snebragd/stringent/Hardware/plotter3.stl

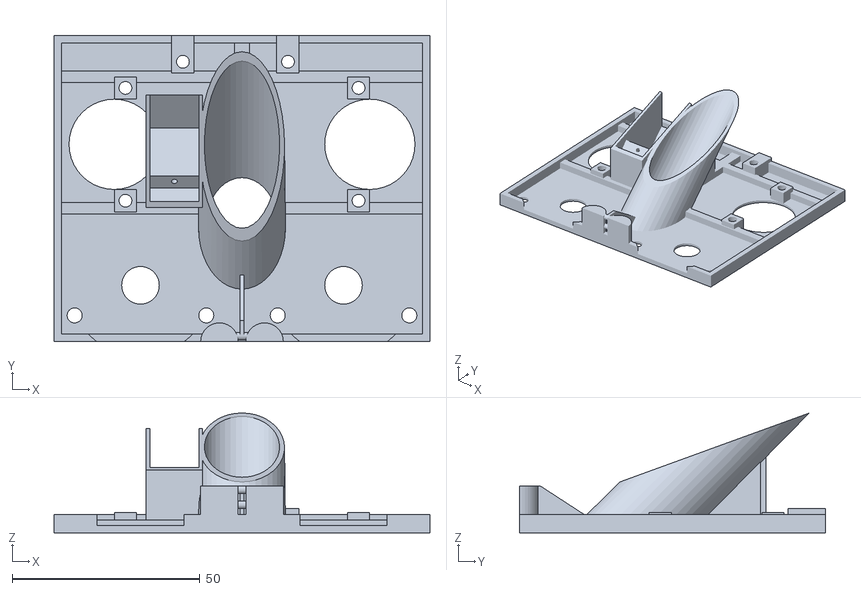
[picture p1: CAD file, 2018-07-29]
Hardware/plotter3.stl
100.0 x 81.5 x 31.9
