snebragd/stringent/Hardware/plotter2.stl

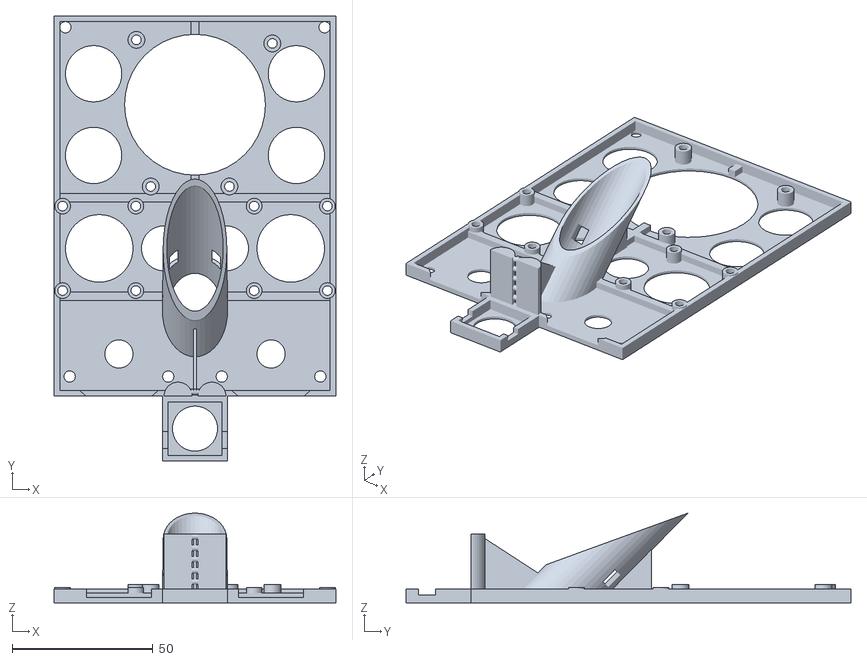
[picture p2: CAD file, 2018-07-14]
Hardware/plotter2.stl
100.0 x 158.0 x 31.9
