snebragd/stringent/Hardware/hanger.stl

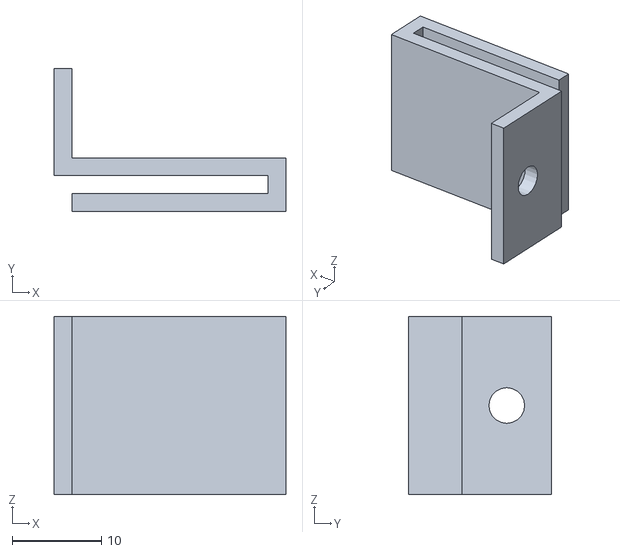
[picture p3: CAD file, 2015-02-15]
Hardware/hanger.stl
26.0 x 16.0 x 20.0
