snebragd/stringent/Hardware/spool2.stl

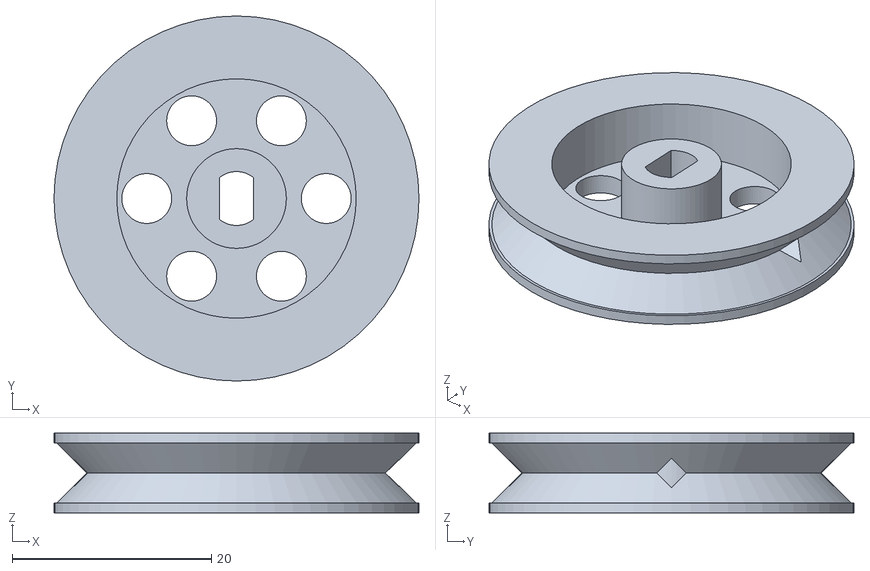
[picture p4: CAD file, 2015-01-25]
Hardware/spool2.stl
36.6 x 36.6 x 8.00
