snebragd/stringent/(list of files, cad)

Other CAD files:
Hardware/plotter3.scad
Hardware/arduino.scad
