snebragd/stringent/Software/plotter/persistent_storage.ino

#include <EEPROM.h>
#include "MachineDefs.h"
 
void eepromWriteLong(int addr, long data) {
  for(int b=0 ; b<4 ; b++) {
    EEPROM.write(addr+b, data & 0xff);
    data = data >> 8;
  }
}

void eepromWriteFloat(int addr, float data) {
  long tmp = *(long*)&data;
  eepromWriteLong(addr, tmp);
}

long eepromReadLong(int addr) {
  long ret = 0;
  for(int b=0 ; b<4 ; b++) {
    ret = (ret<<8) | EEPROM.read(addr+(3-b));
  }
  return ret;
}

float eepromReadFloat(int addr) {
  long tmp = eepromReadLong(addr);  
  return *(float*)&tmp;
}
