snebragd/stringent/(commit log)

2015-01-25 Initial commit.
    [arduino.scad, hello_world.dxf, plotter.scad, plotter.stl, plotter2.scad, plotter2_base.stl, spool.scad, spool2.scad]
2015-02-02 Fixed CMYK plot of targa file. Works now.
    [data.ino, plotter.ino]
2015-02-15 - Added new calibration mode - Added eeprom persistence of position (saved after completed drawing - Added design for a hanger clip
    [hanger.scad, hanger.stl]
2015-02-16 - return to origo after plot - button (power) for saving state to eeprom - added linear "smooth" servo - removed targa support altogether
2015-03-27 Hmm, various. - battery meter - stop/resume function with eeprom persistence - switched stepper direction (HW mismatch between v2 and v3 board) - size now function of disparity (0.3 default, 0.15 and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
    [plotter3.scad]
2015-04-21 Acceleration fixes. Now smoother and faster max speed possible.
    [data.ino, plotter.ino, servo_control.ino, step_control.ino]
2015-04-25 Adding simulator. First step done, compiles and runs through a plot printing stepper motor interactions.
2015-05-03 Fixed buf in float parsing. Now only using two first digits past decimal separator.
    [data.ino]
2015-06-01 Added more parsing hacks to handle svg files better. Still missing handling of trasformation matrix which is needed when using more than one object in inkscape.
    [PlotVisualizer.java, data.ino, plotter.ino, sim.c]
2018-06-23 Random cleanup. Uncomitted things since years. Sorry about this mess.
    deleted: Designs/circle2.svg
    deleted: Designs/circle2_filled.svg
    deleted: Designs/hello_world.dxf
    deleted: Designs/notes_splines.svg
    deleted: Designs/spotify.dxf
    deleted: Designs/spotify.dxf.2014_12_18_19_27_27.0.svg
    deleted: Designs/spotify.svg
    deleted: Designs/tomte.dxf
    new file: Documentation/BOM.txt
    modified: Documentation/HOWTO.txt
    modified: Documentation/ir-codes.txt
    deleted: Documentation/ir-codes.txt~
    renamed: Hardware/schematics.svg -> Documentation/schematics.svg
    modified: Documentation/todo.txt
    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
    [hello_world.dxf, plotter.scad, plotter3.scad, spool.scad, spotify.dxf, stepper_spool.stl, tomte.dxf]
2018-07-14 Regenerated stl file for base. removed old files.
    deleted: Hardware/plotter.stl
    deleted: Hardware/plotter2_base.stl
    added: Hardware/plotter2.stl
    [plotter.stl, plotter2.stl, plotter2_base.stl]
2018-07-15 Various cleanup. Mostly moving servo and ir away from pin 0-1 to allow serial debugging.
2018-07-17 Added serial debug printout of IR hex value for unknown codes. Just stupid not to...
2018-07-17 Fixed broken "make_pen_noise". Added some serial debug printout for the opening of plot file.
    [data.ino, servo_control.ino]
2018-07-17 Servo cleanup. Stop touching the pen to the walll at startup!
2018-07-17 Fixed broken disabling of steppers when idle.
    [plotter.ino, step_control.ino]
2018-07-29 Added new plotter design - moved servo to slide pen rather than pushing entire plotter - much smaller footprint, easier to 3d-print
    [plotter3.scad, plotter3.stl]
2018-07-29 Reduced max speed of steppers. - Plotter was missing steps at high speed under load. Testing showed that goign from old to new setting improved from lifting 400g to 600g - Patience is a virtue...
    [step_control.ino]
2018-07-29 Moved RECV_PIN to A0 to enable IR receiver component to be plugged directly into the board without any cabling. Such win. Less is more.
    Also changed PEN_UP/PEN_DOWN to reasonable values for the plotter3 design.
2018-07-29 A few changes mixed together. - more use of "makePenNoise" for better interactivity with IR - Added "testPen" to when left calibration is done. This proved to be a quite convenient time to adjust the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
    [data.ino, ir_control.ino, servo_control.ino]
2018-07-29 Updated schematics to use A0/A5 pins
2018-07-31 updated plotter3.scad, was an old version, should be better now.
    [plotter3.scad]
